noodlefighter/osu-keyboard-v2/README.md

# Noodlefighter Osu Keyboard
v2 is a branch of this project.

least version:v2.11

-
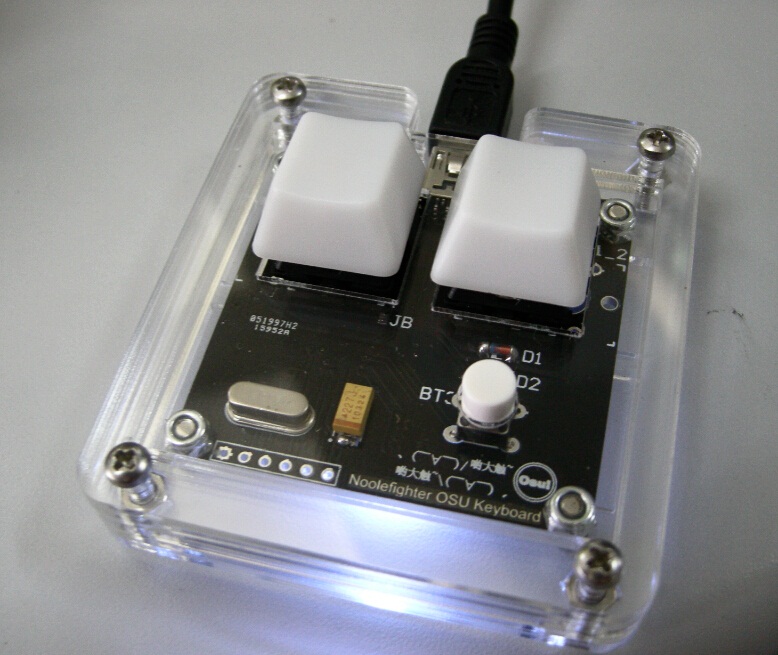
[picture p1: pic.jpg]
