noodlefighter/osu-keyboard-v2/(list of files, cad)

Other CAD files:
Shell/standard.dwg
Shell/mini.dwg
