noodlefighter/osu-keyboard-v2/(list of files, drawings)

Other design files:
PCB/cherry_mx.PcbLib
PCB/OSUpcb.SchDoc
